janpfrang/shelly_power_logger/documentation/HW_Description_Shelly_Logger_v1_3.docx

BRAUN

Shelly Power Logger

Hardware Description Document • v1.3

Portable 230 V power logger

Shelly Plug S MTR Gen3 + ESP32-WROOM-32 + DS3231 RTC + MicroSD

Author: Jan Pfrang | jan.pfrang@delonghigroup.com

Date: June 25 2026

⚑ Merged from v1.1 and v1.2. Updated for firmware v4: push cadence 1 s → 1.2 s; WiFi mode WIFI_AP_STA → WIFI_AP; DNS/mDNS disabled; watchdog 3 s → 5 s confirmed; SD flush timeout guard added; undervoltage detection section expanded (HW present, SW pending activation).

# 1. System Overview

The BRAUN Shelly Power Logger is a portable, self-contained instrument for measuring and recording the power consumption of 230 V / 16 A appliances. It requires no external Wi-Fi router or internet connectivity — the entire system forms its own local network.

## 1.1 Architecture

The system consists of three physical units:

- Shelly Plug S MTR Gen3 — CE-marked smart plug measuring voltage, current, and active power at ~1 Hz. Runs a custom script (shelly_push.js) that pushes JSON measurements over Wi-Fi to the ESP32 every 1.2 seconds (push interval increased from 1.0 s in firmware v4 to eliminate a timer race condition — see §6).
- ESP32-WROOM-32 — acts as the Wi-Fi access point (WIFI_AP mode, no STA interface), web server, RAM buffer, SD card writer, and real-time clock host. Serves a browser-based dashboard over HTTP. DNS catch-all and mDNS are disabled in firmware v4.
- DS3231 ZS042 RTC module — provides accurate, battery-backed wall-clock timestamps for log entries, connected via I²C (GPIO 21/22).

## 1.2 Data flow

shelly_push.js → POST /api/shelly_push → ShellyClient::ingest() → Logger::pollIfDue() → RAM ring buffer → SD card (CSV)

## 1.3 Key specifications

Parameter | Value
Mains supply | 230 V AC, 50 Hz
Max load current | 10 A (2500 W)
Shelly push cadence | 1.2 s (firmware v4; was 1.0 s in v3)
Measurement cadence (logging) | 1 s (default); adjustable 1 / 2 / 5 / 10 / 30 s
SD flush interval | Every 10 s (400 ms timeout guard added in v4)
RAM buffer depth | 64 samples (~64 s reserve)
Log format (CSV columns) | datetime, time_ms, voltage_V, power_W, pf_apparent
Wi-Fi mode | WIFI_AP (AP only, no STA) + WiFi.setSleep(false)
Wi-Fi SSID / password | PZEM_Logger / logger1234
Web interface | http://192.168.4.1 (direct IP — mDNS disabled in v4)
RTC accuracy | DS3231 ±2 ppm (±63 s/year)
LED: 1 Hz blink | System healthy (Shelly pushing, SD OK)
LED: 5 Hz blink | Error — Shelly silent > 5 s, or SD fault

# 2. Component List

Component | Description | Notes
Shelly Plug S MTR Gen3 | Smart plug, 230 V / 10 A, built-in energy meter | CE-marked; shelly_push.js installed
ESP32-WROOM-32 | Dual-core 240 MHz, 4 MB flash, Wi-Fi + BT | Arduino framework
DS3231 ZS042 module | I²C RTC, TCXO-compensated, CR2032 backup | Address 0x68; see §4.2 battery note
MicroSD card | FAT32-formatted, any capacity | Writes CSV log.csv
230 V → 9 V PSU | Mains-rated isolated supply, ≥ 500 mA | Must be safety-certified; feeds TSR-1-2450
TSR-1-2450 (DC-DC) | 9 V → 5 V buck regulator | Regulated supply for ESP32; drops out at ~6.5 V input
Status LED | Single LED + current-limiting resistor (R3 = 220 Ω) | Connected to GPIO 32, active-HIGH
Reset button | Tactile pushbutton | GPIO 33, INPUT_PULLUP (future firmware use)
Supercapacitors C1/C2 | 2 × 0.47 F (or higher), ≥ 5 V rated | Series stack for power-loss hold-up (§5)
Balancing resistors R_bal1/R_bal2 | 2 × 100 kΩ | Passive voltage equalisation for 2S supercap stack (§5)
Schottky diodes D1/D2 | 2 × 1N5822 | Prevents reverse discharge from supercaps back into PSU
Fuse F1 | 0.5 A (fuse for protection) | Protects power supply path
Resistor R3 | 10 Ω, 2 W | NTC / inrush limiter (cold resistance ~10 Ω)
Voltage divider R1/R2 | R1 = 180 kΩ, R2 = 47 kΩ | 9 V rail → GPIO 35 ADC for undervoltage detection (§5)
Decoupling C3 | 100 µF electrolytic | Supply decoupling
Decoupling C4 | 10 nF ceramic | High-frequency decoupling

## 2.1 Complete Circuit Schematic

The schematic shows the complete wiring of the logger. The LED circuit is active-HIGH: GPIO 32 sources current through R3 (220 Ω) and the LED to GND, matching the firmware logic in StatusLed.h.

⚠ Known schematic errors in Rev 1.1: C1 = C2 shown as 1 F — actual BOM value is 0.47 F. NTC shown as 10 Ω — this is correct only when cold; the NTC is a thermistor and resistance falls with temperature. Update schematic to Rev 1.2 when corrected.

Figure 1 — Complete circuit schematic Rev 1.1. See warning above for known discrepancies.

# 3. ESP32 Pin Assignment

The table below documents every GPIO used in this design. GPIOs 16 and 17 were used for the PZEM UART in the previous hardware revision; they are now free after the switch to the wireless Shelly sensor.

Figure 2 — ESP32-WROOM-32 complete GPIO assignment. Faded entries are unconnected.

GPIO / Pin | Connected to | Category
3.3V | RTC VCC + board supply rail | Power
GND | RTC GND + board ground | Power
5V / VIN | 5 V input from TSR-1-2450 | Power
GPIO 14 | SD card MOSI (SPI VSPI) | SD SPI
GPIO 25 | SD card CS | SD SPI
GPIO 26 | SD card MISO (SPI VSPI) | SD SPI
GPIO 27 | SD card CLK (SPI VSPI, 4 MHz) | SD SPI
GPIO 21 | RTC DS3231 SDA (I²C) | RTC I2C
GPIO 22 | RTC DS3231 SCL (I²C) | RTC I2C
GPIO 32 | Status LED (active-HIGH output) | UI
GPIO 33 | Reset button (INPUT_PULLUP, future use) | UI
GPIO 35 | Supply voltage ADC — 9 V rail via R1/R2 divider (input only, no internal pull) | ADC / Power monitor
GPIO 16 | Free (formerly PZEM UART2 RX) | Free
GPIO 17 | Free (formerly PZEM UART2 TX) | Free
GPIO 1 | UART0 TX (Serial / debug) | System
GPIO 3 | UART0 RX (Serial / debug) | System
GPIO 0 | Boot strapping — do not drive | System
GPIO 2 | Boot strapping — do not drive | System
GPIO 15, 4, 5, 18, 19, 23 | Free | Free
GPIO 34, 36, 39 | Free (input only, no pull) | Free

# 4. DS3231 RTC Wiring

The DS3231 ZS042 module connects to the ESP32 via the hardware I²C bus (Wire bus 0). GPIO 21 and GPIO 22 are the dedicated SDA and SCL pins on the ESP32-WROOM-32.

Figure 3 — DS3231 ZS042 to ESP32 wiring. All signals are 3.3 V logic.

## 4.1 Connection table

DS3231 pin | ESP32 pin | Signal | Notes
SDA | GPIO 21 | I²C data | 4.7 kΩ pull-up to 3.3 V recommended
SCL | GPIO 22 | I²C clock | 4.7 kΩ pull-up to 3.3 V recommended
VCC | 3.3V | Power | Do NOT connect to 5V
GND | GND | Ground
32K | — | 32 kHz output | Leave unconnected if unused
SQW | — | Square wave / INT | Leave unconnected if unused

## 4.2 Battery note (ZS042 module)

Many ZS042 boards include a trickle-charging circuit (R1, typically 200 Ω) intended for LIR2032 rechargeable cells. If a non-rechargeable CR2032 is installed, this resistor must be removed or the VCC→BAT trace cut to prevent overcharging the cell.

# 5. Undervoltage Detection and Power-Loss Hold-Up

The logger includes a hardware circuit for detecting mains power loss and providing a hold-up window during which the firmware can safely flush the SD card before the system shuts down. This implements Requirement 13.

⚑ Hardware: fully implemented and present on the PCB. Firmware: PowerMonitor.h is written and complete but POWER_MONITOR_ENABLED is set to 0 in Config.h until the circuit is bench-validated. Set POWER_MONITOR_ENABLED = 1 to activate.

## 5.1 Power chain

The 9 V supply rail feeds both the power-loss detection circuit and the TSR-1-2450 DC-DC converter:

230 V AC → [PSU] → 9 V DC rail → [TSR-1-2450] → 5 V → [ESP32 LDO] → 3.3 V

The TSR-1-2450 loses regulation at approximately 6.5 V input. Below this point the 3.3 V rail (and therefore the ADC reference) becomes unreliable. The firmware triggers the SD flush at 7.35 V — well above the 6.5 V cliff — to ensure the ADC is still trustworthy when the shutdown decision is made.

## 5.2 Supercapacitor hold-up

Two supercapacitors (C1 and C2, each 0.47 F) are stacked in series across the 9 V rail, giving an effective capacitance of 0.235 F. When mains power is lost the capacitors discharge through the load, holding the 9 V rail above the 7.35 V detection threshold for approximately 4.5 seconds at the nominal 150 mA system current — providing ample time for the SD card flush (typically < 100 ms) and load shedding.

⚠ BOM / schematic error: C1 and C2 are shown as 1 F in the Rev 1.1 schematic. The actual installed value is 0.47 F each (0.235 F effective series). Update schematic to Rev 1.2. Verify voltage rating: common coin supercaps are rated 2.7 V — a 2S stack at 9 V (4.5 V per cell) would overvolt them. Use capacitors rated ≥ 5 V per cell.

## 5.3 Voltage divider (R1 / R2)

The 9 V rail is scaled down to the ESP32 ADC input range (0–3.3 V) via a resistor divider on GPIO 35:

9V rail —[ R1: 180 kΩ ]—+—[ R2: 47 kΩ ]— GND

GPIO 35 (ADC1_CH7) ↑ tapped here

Parameter | Value | Formula | Notes
Divider ratio | 0.207 | 47k / (180k + 47k) | GPIO voltage = 9V × 0.207 = 1.86 V at nominal rail
GPIO voltage at 9 V | 1.86 V | 9 × 0.207 | Well within ADC linear region (0.8–2.5 V)
Trigger threshold | 7.35 V rail | Config.h POWER_THRESHOLD_LOW_MV | = 1.52 V at GPIO 35
Recovery threshold | 7.75 V rail | Config.h POWER_THRESHOLD_HIGH_MV | Hysteresis prevents chatter
ADC oversampling | 16 samples | POWER_ADC_SAMPLES | Reduces WiFi noise coupling
Majority voting | 3 consecutive | POWER_MAJORITY_COUNT | Prevents single-spike trigger
ADC source impedance | ~38 kΩ | R1 ‖ R2 = 180k ‖ 47k | Add 100 nF C4 to GND to reduce settling time

## 5.4 Supercapacitor balancing (R_bal1 / R_bal2)

Two passive balancing resistors (R_bal1 = R_bal2 = 100 kΩ) are connected across each supercapacitor to equalise the voltage across each cell and prevent either from exceeding its rated voltage due to leakage current mismatch.

R_bal1 connects from the positive supply rail (+9 V) to the midpoint (junction of C1 and C2). R_bal2 connects from the midpoint to GND. Together they force the midpoint to +4.5 V regardless of individual capacitor leakage.

Parameter | Value | Formula | Notes
Supply voltage | 9 V | — | Across C1 + C2 in series
Voltage per cap | 4.5 V | 9 V / 2 | Must be ≤ cap voltage rating
R_bal1 = R_bal2 | 100 kΩ | Equal divider | Higher R = lower bleed current
Bleed current | ≈ 90 µA | 9V / 100kΩ | Negligible power loss
Power per resistor | ≈ 0.4 mW | 4.5² / 100k | Well within 0.25 W rating

## 5.5 Firmware behaviour (when POWER_MONITOR_ENABLED = 1)

Once activated in Config.h, PowerMonitor.h runs the following sequence on mains loss:

- GPIO 35 is sampled every 200 ms (16 oversampled reads, averaged).
- If 3 consecutive samples read below 7.35 V, isPowerLost() latches true.
- loop() calls handlePowerLoss(): flushes SD card (typically < 100 ms), then turns off Wi-Fi to save power (~80–120 mA saving extends hold-up by several seconds).
- If the 9 V rail recovers above 7.75 V for 10 consecutive checks (~1 s), the ESP32 reboots cleanly and logging resumes.
- If the rail continues to fall, the ESP32 brownout detector triggers hardware reset at ~2.4 V.

# 6. Firmware Module Overview

⚑ Updated for firmware v4: push cadence 1 s → 1.2 s; WiFi mode WIFI_AP_STA → WIFI_AP; mDNS/DNS disabled; watchdog 5 s; SD flush timeout guard; download watchdog grace.

File | Responsibility
Config.h | All pin definitions, timing constants, Wi-Fi credentials, SD path, thresholds. POWER_MONITOR_ENABLED flag here.
ShellyClient.h | Receives and validates JSON push from Shelly. Watchdog timer (5 s silence = error). Startup grace (15 s) on boot and download.
Logger.h | RAM ring buffer (64 entries), SD card writes (10 s flush, 400 ms timeout guard), poll scheduling, power threshold filter.
WebPortal.h / .cpp | HTTP server, all web pages and API endpoints. DNS catch-all and mDNS DISABLED in v4. beginStartupGrace() called before file download.
StatusLed.h | Non-blocking LED blink — 1 Hz OK, 5 Hz error.
PowerMonitor.h | 9 V rail ADC monitor (GPIO 35). Triggers safe SD flush on mains loss (Req 13). Currently DISABLED (POWER_MONITOR_ENABLED = 0).
shelly_push.js | Runs ON the Shelly device. Reads meter and POSTs JSON every 1.2 s (was 1.0 s in v3). HTTP timeout 2 s (was 1 s).
Shelly_ESP32_Logger.ino | Main sketch: object instantiation, setup(), loop(). Loop order: webPortal.update() → pollIfDue() → flushIfDue() → LED.

## 6.1 Loop execution order

The order of operations in loop() matters for timing correctness. webPortal.update() runs first so incoming Shelly data is available to Logger::pollIfDue() in the same iteration:

Step | Call | Purpose
0 | powerMonitor.update() | Check 9 V rail — if lost, flush SD and halt (never returns)
1 | webPortal.update() | Serve HTTP; ingest Shelly push into cache ← FIRST
2 | logger.pollIfDue() | Read fresh cache; write sample to RAM buffer if 1 s elapsed
3 | logger.flushIfDue() | Write RAM buffer to SD if 10 s elapsed
4 | statusLed.update() | Update LED: 1 Hz if ok(), 5 Hz if error

## 6.2 Required Arduino libraries

- ArduinoJson by Benoit Blanchon (≥ v6.x) — JSON parse/serialise
- RTClib by Adafruit — DS3231 driver
- SD (built-in ESP32 core)
- WiFi, WebServer, ESPmDNS, DNSServer (built-in ESP32 core — ESPmDNS/DNSServer included but not actively used in v4)

# 7. Document Changelog

Version | Date | Changes
v1.1 | May 28 2026 | Initial merged document. Added DS3231 RTC section. Supercapacitor balancing section. Firmware module table.
v1.2 | June 24 2026 | Watchdog timeout corrected 3 s → 5 s. CSV column 'datetime' added to key specs. PowerMonitor.h added to firmware module table.
v1.3 | June 25 2026 | Merged v1.1 and v1.2 into single document. Updated for firmware v4: push cadence 1.0 s → 1.2 s; WiFi mode WIFI_AP_STA → WIFI_AP + WiFi.setSleep(false); DNS catch-all and mDNS disabled; SD flush timeout guard (400 ms) added; download watchdog grace (beginStartupGrace) noted. Undervoltage detection expanded into full section (§5) covering power chain, hold-up calculation, divider design, balancing, and firmware sequence. Schematic errors documented. TSR-1-2450 added to component list. Web interface URL updated to direct IP only.

End of document

BRAUN Shelly Power Logger Page of

BRAUN Shelly Power Logger — Hardware Description v1.3 | jan.pfrang@delonghigroup.com
