janpfrang/shelly_power_logger/documentation/electronics_BOM.md

# Bill of Materials (BOM)
 
**Title:** Power Monitor and Logger
**Version:** V 1.02
**Date:** 11 June 2026
 
---
 
## Information
 
BOM for improved functionalty including RTC and undervoltage protection and fuse
 
---
 
## Components
 
| ID | Item | Description | Supplier | Supplier ID | Quantity | Price for Required Quantity |
|----|---|---|---|---|---|---|
| 1  |  ESP32 |Node MCU / ESP-Wroom-32 (LX6) | Reichelt | | 1 | 7.30 € |
| 2  |(micro) SD-Shield |SPI, best 3.3 V without LDO - bare shield |Ebay | |1 | 4.00 € |
| 3  |micro SD-card |FAT32 < 16 GB |amazon - Intenso 16 GB | |1 | 4.00 € |
| 4  |Power supply |9 V with 5.5-2.1 mm jack, CE marked |Conrad |ID002355712 |1 | 8.49 € |
| 5  |Shelly Plug S MTR Gen3 |power monitor plug adapter |Conrad | |1 | 17.00 € |
| 6  |Housing |distribution box, 100x100x50 mm |Hardware store - Bauhaus | |1 |  1.99 € |
| 7  |Socket |hollow pin 5.5 - 2.1 mm |Conrad | | 1 | 3.00 € | 
| 8  |Real time clock |I2C DS3231 ZS042 |ebay | | 1 | 2.53€ | 
| 9  |R_bal 100 kOhms | 100 k ohms | conrad |  x 003359192 VitrOhm POS100JT-52-100KAA POS100JT-52-100KAA Metallschicht-Widerstand 100 kΩ THT 0207 1 W 5 % 1 St. CE 003359192 Produkt-ID: 003359192 Menge: 4 | 2 |  0.28 € | 
| 10  |R1 180 kOhms | | | | 1 | | 
| 11  |R2 47 kOhms | | | | 1 | | 
| 12  |D2, D2 Diode 1N5822 | set of diods purchased (5x) | | | 2 | 3.17 € | 
| 13  |C1, C2 | Supercap 5.5V/0.47F | | 2 | 2 | 1.99 € | 
| 14  |R 3 10 Ω inrush limitier | 10 Ω 2 W | ebay | | 1 | 1.00 € | 
| 15  |U1 DC/DC converter | 000156673 TracoPower TSR 1-2450 DC/DC-Wandler, Print 24 V/DC 5 V/DC 1 A 6 W Anzahl Ausgänge: 1 x Inhalt 1 St.CE 000156673 Produkt-ID: 000156673 | Conrad | 000156673 | 1 |  6.49 € | 
| 16  |C3 100µF elko power supply | | | | 1 | |
| 17  |Current limiting fuse 0.5A slow |  Feinsicherung 5x20mm, träge 0,5A | reichelt.de | Artikel-Nr.: TR 0,5A Hst.-Teile-Nr.: 522.514 | 1 |  0.48 € | 
| 18  |fuse folder | Sicherungshalter, 5x20mm, print, mit Abdeckkappe | reichelt.de | Artikel-Nr.: MTA 506000 / Hst.-Teile-Nr.: 506000 | 1 |  0.32 € | 
| 19  |C4 10 nF ceramic power supply | | | | | |
| 17  |empty on purpose | | | | 1 |  ?.?? € | 

---
 
*Total Cost:*
