janpfrang/shelly_power_logger/(commit log)

2026-05-25 shelly to esp32 to mobil - works
    sd yet not tested / connected
2026-05-25 Create architecture.md for power logger documentation
    Added detailed architecture and data flow documentation for the Shelly ESP32 Power Logger project.
2026-05-27 Update built_firmware.yml
    compile the thing and get an esp32 binary
2026-05-28 HW description and schematics
    save power down capacitors alread contained
    NTC already contained - not in firmware yet
2026-05-28 be aware of the schematics errors!
2026-05-29 Update Shelly_ESP32_Logger.ino
    bug fixes
    [Shelly_ESP32_Logger.ino]
2026-06-02 Add files via upload
    surpressor diode and fuse added
2026-06-08 Update Config.h
    gpio p 35 power loss detection added
2026-06-10 2 capacitors 5v filter added
2026-06-11 Update Config.h
    fix of early kill of wifi due to undervoltage
    [Config.h]
2026-06-11 Update Config.h
    fix of boot order trouble
    [Config.h]
2026-06-11 Update electronics_BOM.md
    capcitor power supply adde, NTC deleted - in accordence to HW description
2026-06-18 Update Config.h
    shelly error threshold changed from 3 s to 5 s
    [Config.h]
2026-06-24 HW descriptio without schematics - merge
2026-06-24 Update Config.h
    enable power log
2026-06-24 Update Logger.h
    power monitor enabled
2026-06-24 Update Logger.h
    test to check sd error and time consumption
    [Logger.h]
2026-06-25 Update WebPortal.cpp
    try to limit the iphone to flood the esp32 with update requests
2026-06-25 Update Config.h
    power monitor is off for testing
2026-06-25 Add files via upload
    schematic is not contained
2026-06-25 Update Config.h
    power monitoring is now activated
2026-06-25 Update Shelly_ESP32_Logger.ino
    power logger / undervoltatge detetciton activated
2026-06-25 Update Shelly_ESP32_Logger.ino
    fix - log never logged power outtage
    [Shelly_ESP32_Logger.ino]
